SosoIlea/PetFeeder/PetFeederFinal.pdf

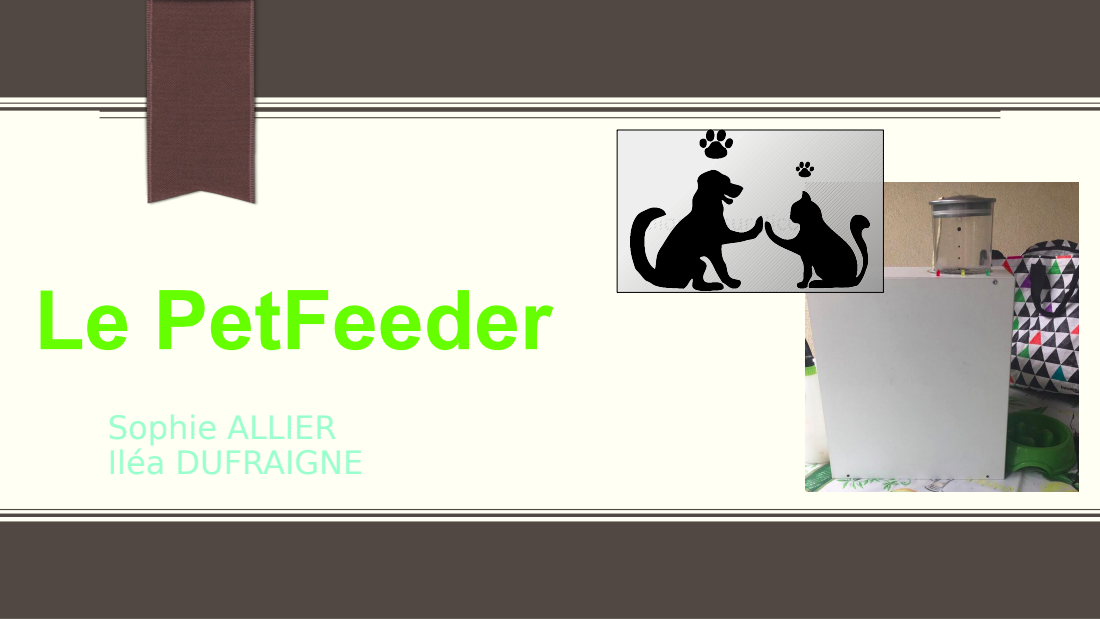
[picture p7: page 1]
Le PetFeeder; Sophie ALLIER Iléa DUFRAIGNE

Cliquez sur l'icône pour ajouter une image

# Sommaire

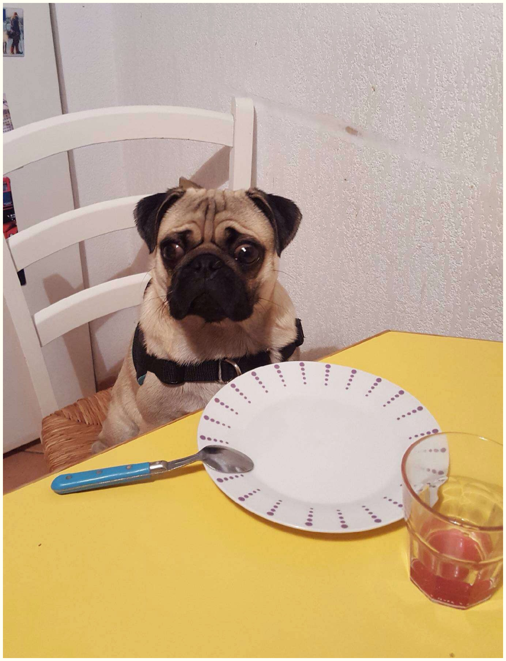
[picture p8: figure]

# - Description - Objectifs - Schémas et matériel - Problèmes rencontrés - Bonus - Perspectives

# Description

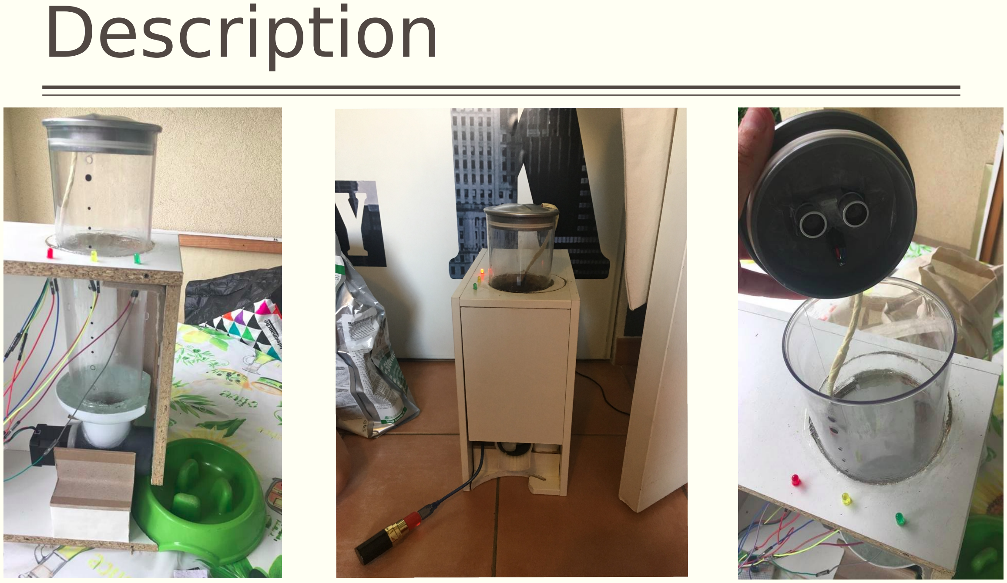
[picture p9: page 3]

# Objectifs

De départ | De fin

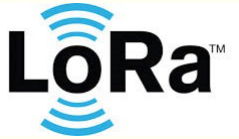
[picture p10: figure]

Utilisation d'une molette et d'un petit moteur pas-à-pas

Utilisation d'une hélice, d'un tuyau et d'un moteur plus puissant

# Tous nos autres objectifs n'ont pas changé !

# Diagramme de Gantt suivi

Tâches | Décembre | Janvier | Février | Mars | Avril | Mai | Juin

Réflexion

Préparation

Programmation

Vérifications

Montage

Finalisation | | | | | | | FIN !!!
Sophie | Iléa | Sophie & Iléa

# Schémas et matériel

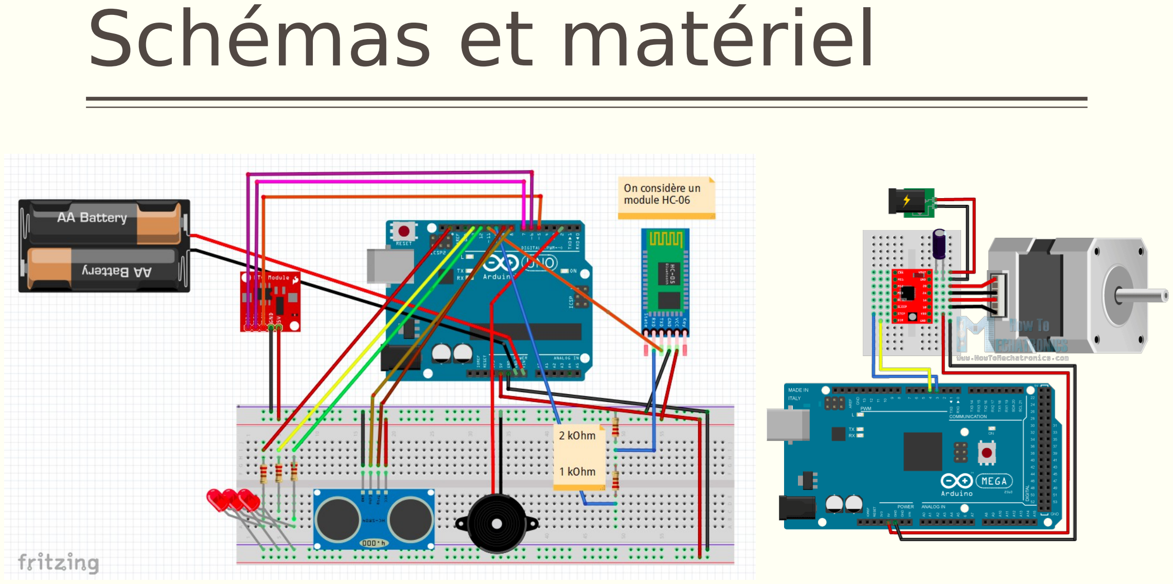
[picture p11: page 6]

# Problèmes rencontrés

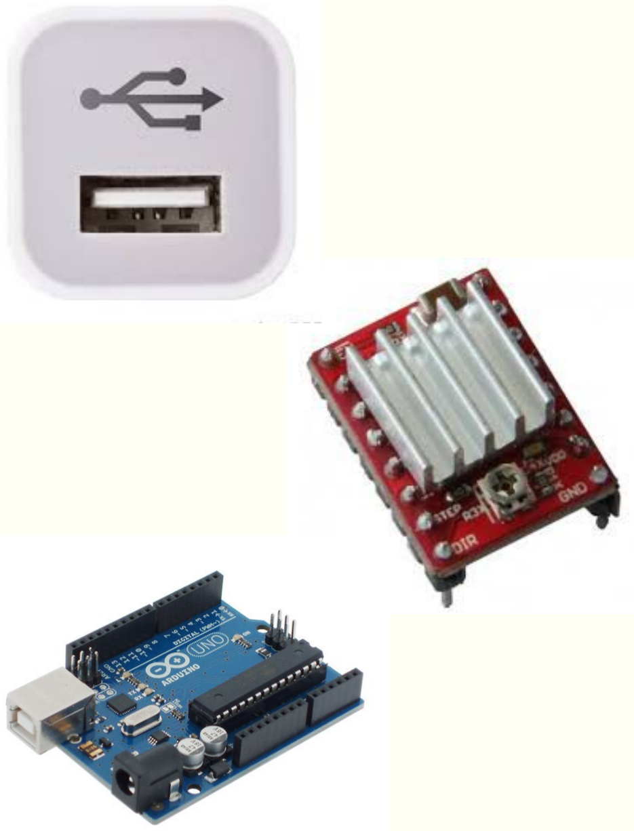
[picture p12: figure]

# ●Problèmes mécaniques

# ●Problèmes éléctroniques

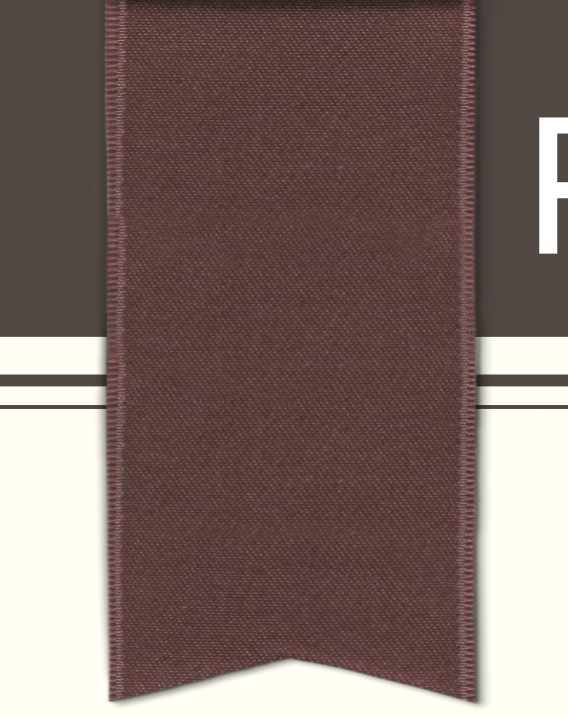
[picture p13: figure]

# Palmarès du binôme de choc :

# - 1 plaque - 1 PWM - 1 module Bluetooth - 1 port USB - 2 cartes Arduino - 4 drivers

## Le talent

Trop fortes

Pour le plus grand plaisir de M.Masson ...

# Perspectives

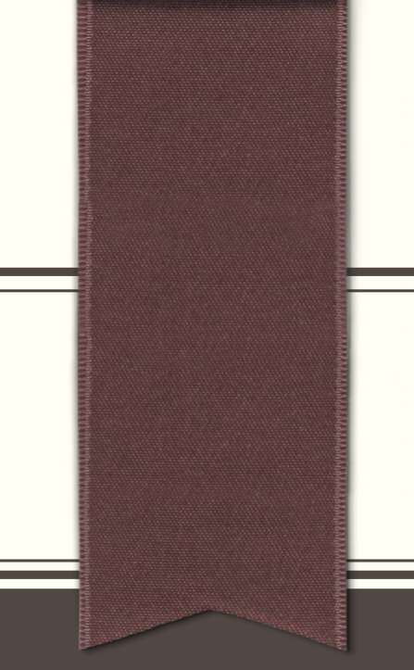
[picture p14: figure]

# - Travailler en équipe

# - Elaborer un projet sur une longue période

# - Faire face aux difficultés et les surmonter

# Merci de votre écoute !

Utilisation pour
d'autres
animaux

Pas de prise
12V

## Possibilité de créer une application pour utiliser le module LoRa
