SosoIlea/PetFeeder/repertoire/doc/Photos/33066060_2187783017917541_4268476646387875840_n.jpg

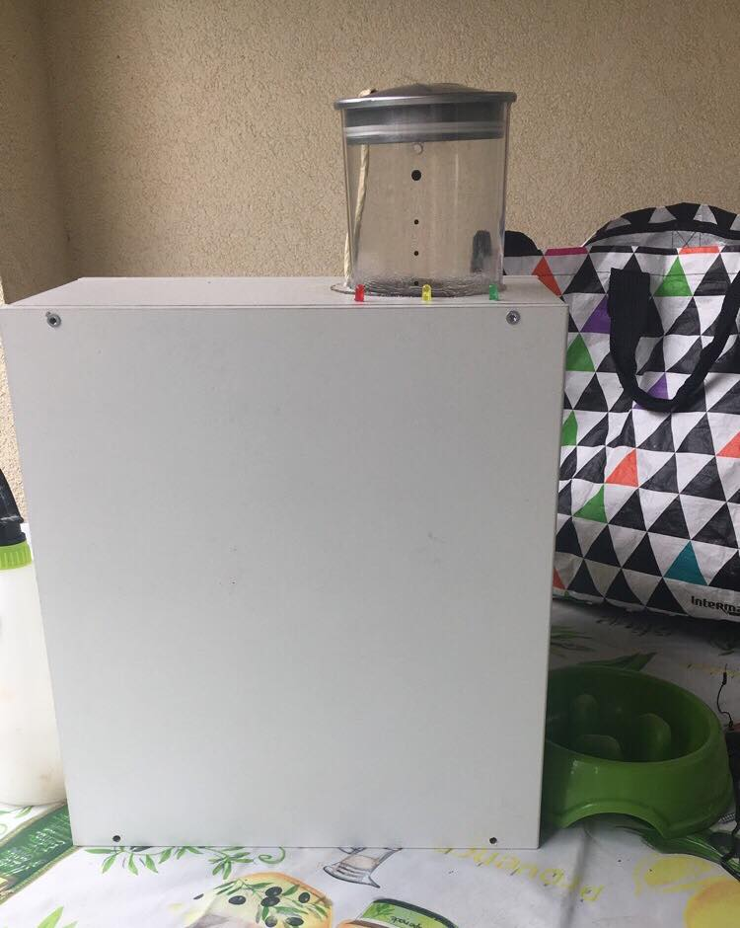
repertoire/doc/Photos/33066060_2187783017917541_4268476646387875840_n.jpg
