SosoIlea/PetFeeder/repertoire/doc/Photos/33100535_2187783351250841_3870072525073416192_n.jpg

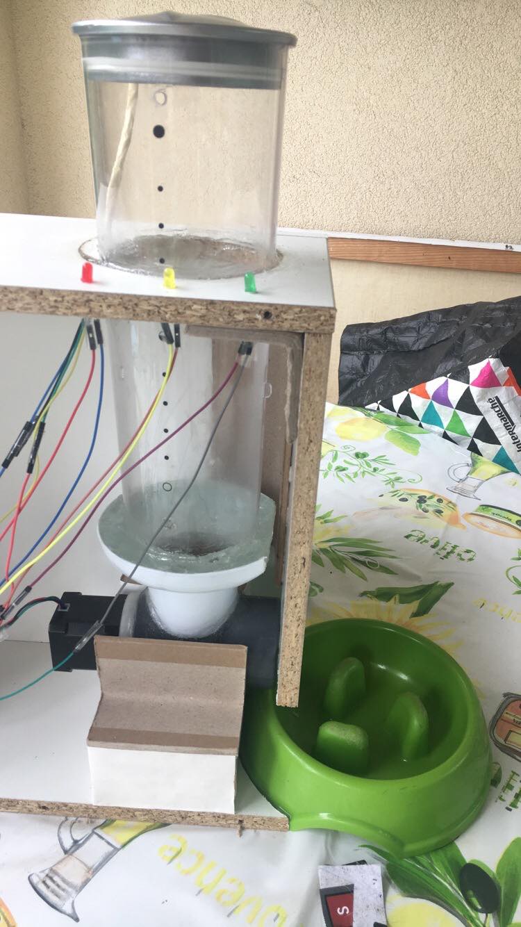
repertoire/doc/Photos/33100535_2187783351250841_3870072525073416192_n.jpg
