SosoIlea/PetFeeder/repertoire/doc/Photos/BD39CEA2-42DF-4465-9EC5-68898302F27A.jpeg

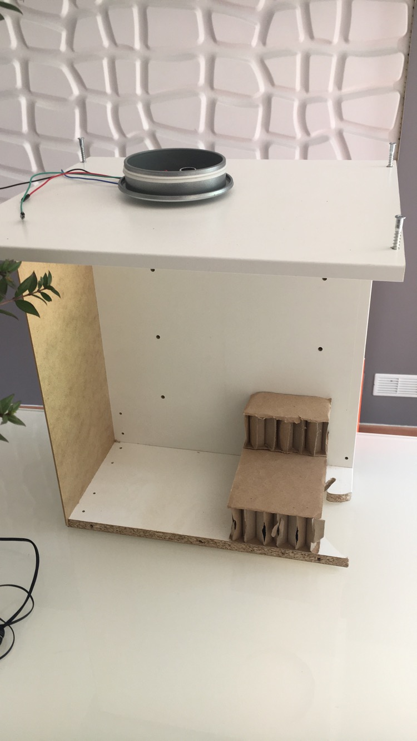
repertoire/doc/Photos/BD39CEA2-42DF-4465-9EC5-68898302F27A.jpeg
