SosoIlea/PetFeeder/repertoire/doc/Photos/BFC08A79-5608-4789-B0F6-804772E7318F.jpeg

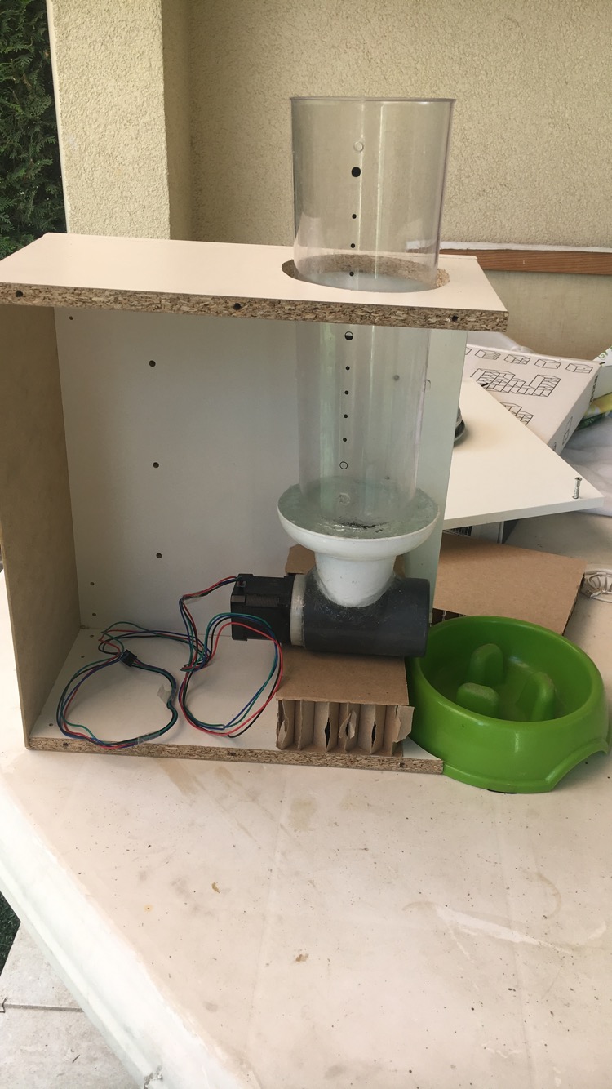
repertoire/doc/Photos/BFC08A79-5608-4789-B0F6-804772E7318F.jpeg
