SosoIlea/PetFeeder/repertoire/doc/Montage/Schema-montage-moteur.png

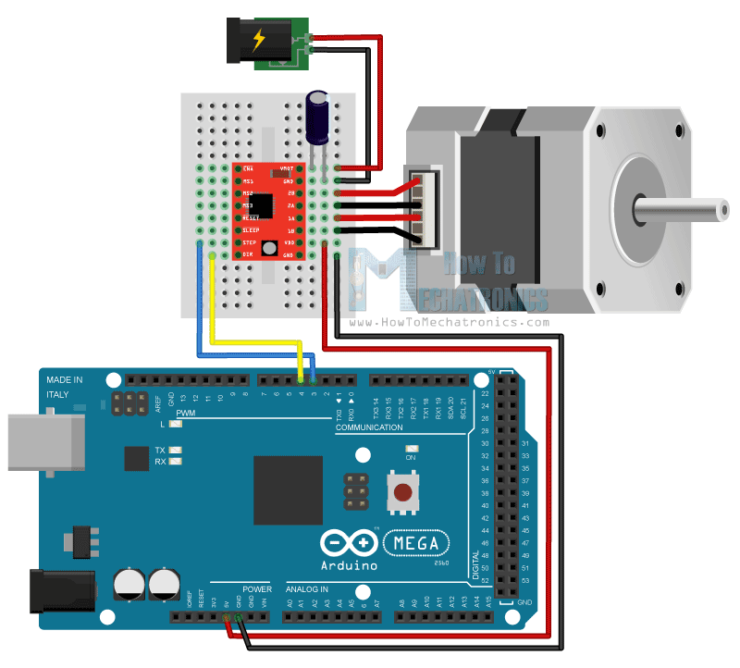
repertoire/doc/Montage/Schema-montage-moteur.png
