SosoIlea/PetFeeder/PetFeefer1.pdf

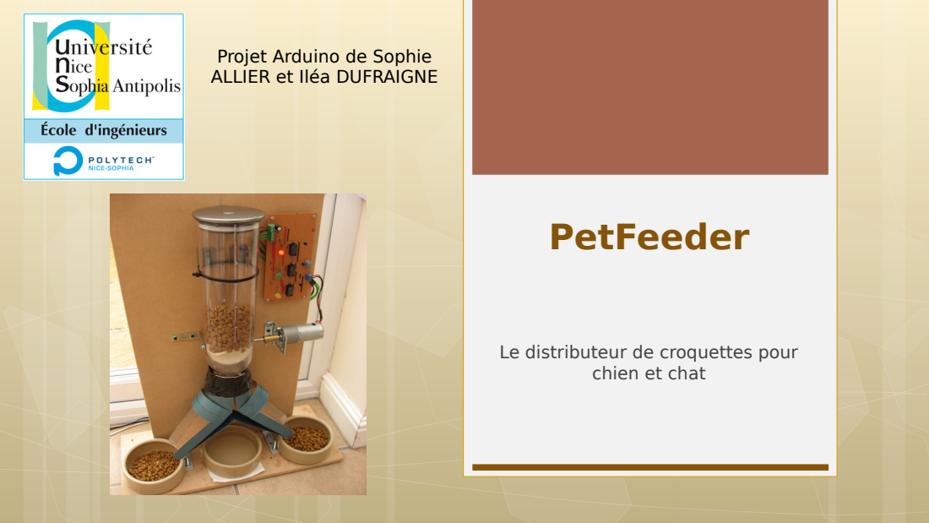
[picture p27: page 1]
PetFeeder

Projet Arduino de Sophie
ALLIER et Iléa DUFRAIGNE

Le distributeur de croquettes pour

chien et chat

## Sommaire

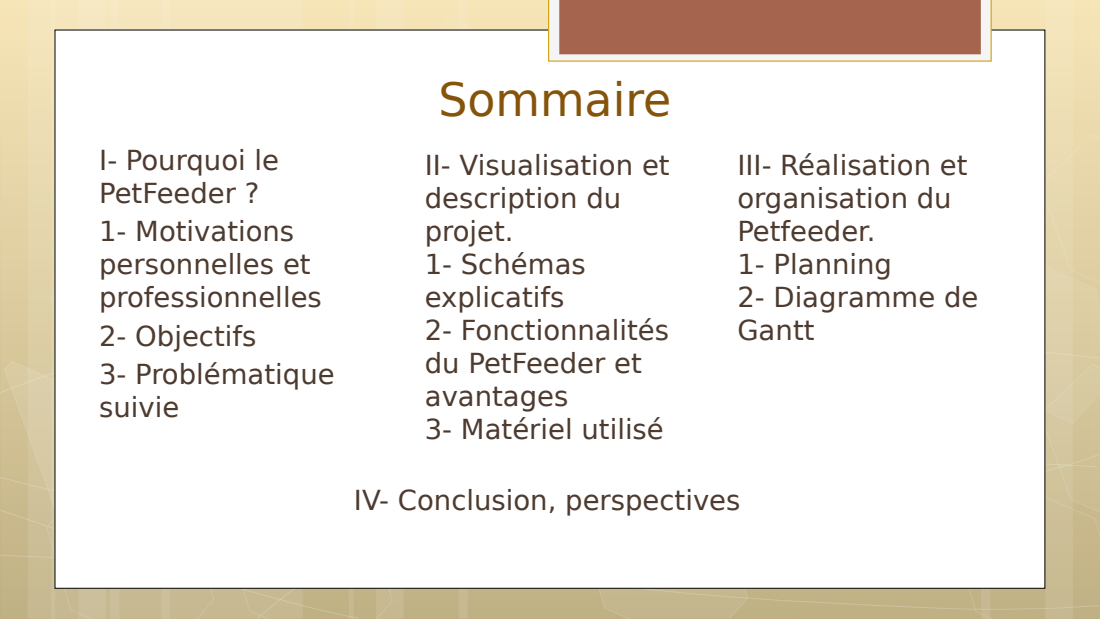
[picture p28: page 2]
I- Pourquoi le PetFeeder ? 1- Motivations personnelles et professionnelles 2- Objectifs 3- Problématique suivie

II- Visualisation et
description du
projet.
1- Schémas
explicatifs
2- Fonctionnalités
du PetFeeder et
avantages
3- Matériel utilisé

III- Réalisation et
organisation du
Petfeeder.
1- Planning
2- Diagramme de
Gantt

IV- Conclusion, perspectives

## Motivations

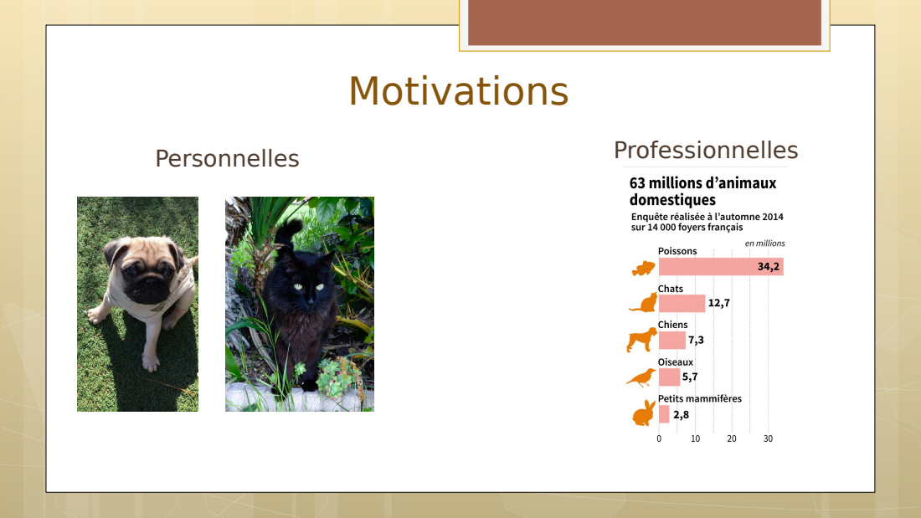
[picture p29: page 3]
Personnelles; Professionnelles

# Objectifs & Problématique

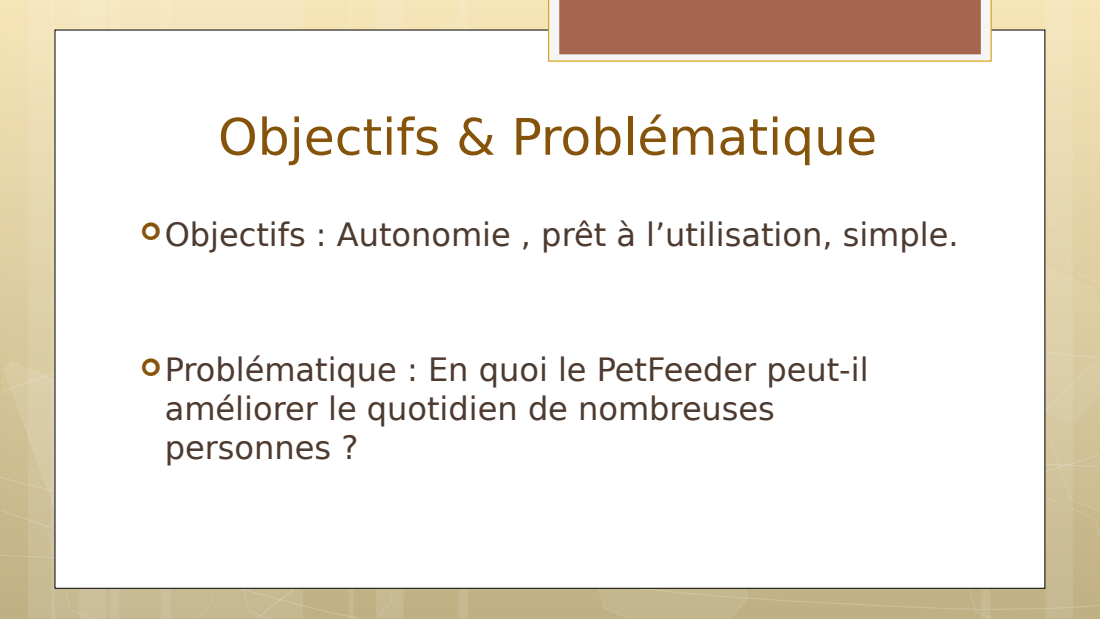
[picture p30: page 4]

Objectifs : Autonomie , prêt à l’utilisation, simple.

Problématique : En quoi le PetFeeder peut-il
améliorer le quotidien de nombreuses
personnes ?

# Schémas

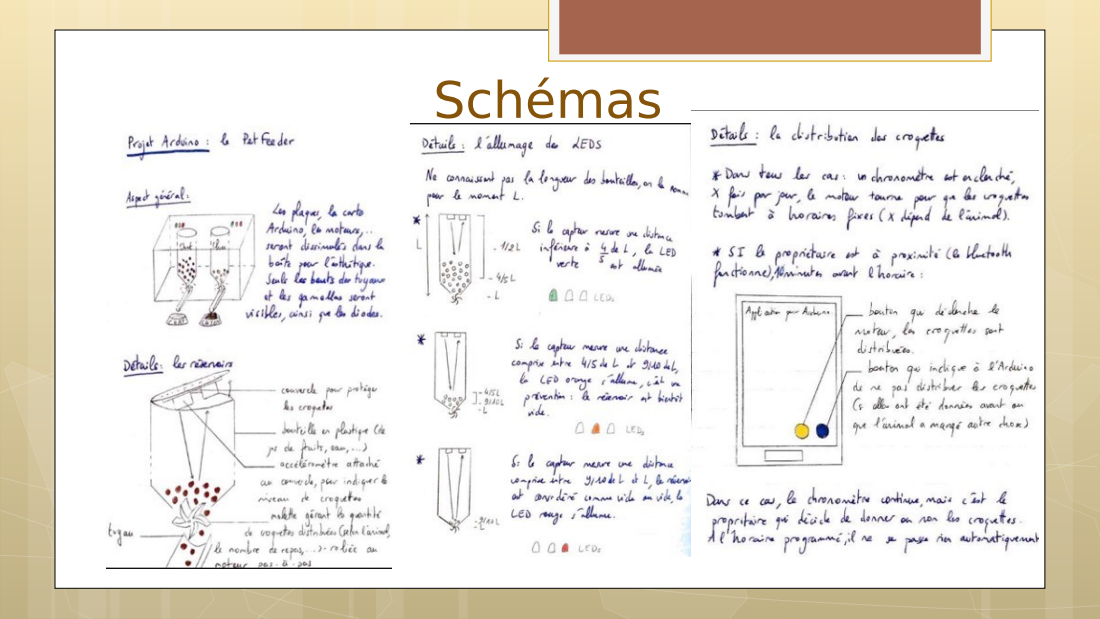
[picture p31: page 5]

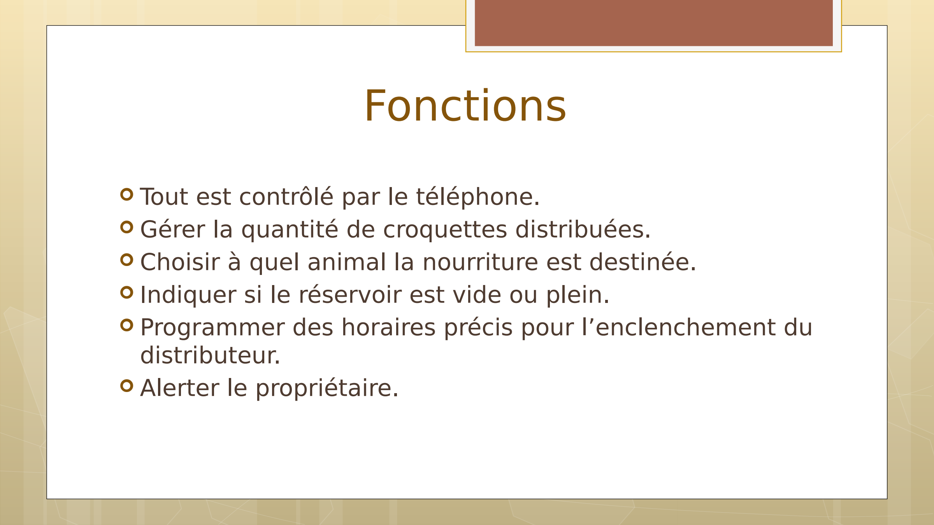
[picture p32: figure]
Fonctions; Tout est contrôlé par le téléphone.; distributeur. Alerter le propriétaire.

Gérer la quantité de croquettes distribuées.
Choisir à quel animal la nourriture est destinée.
Indiquer si le réservoir est vide ou plein.
Programmer des horaires précis pour l’enclenchement du

# Matériel utilisé

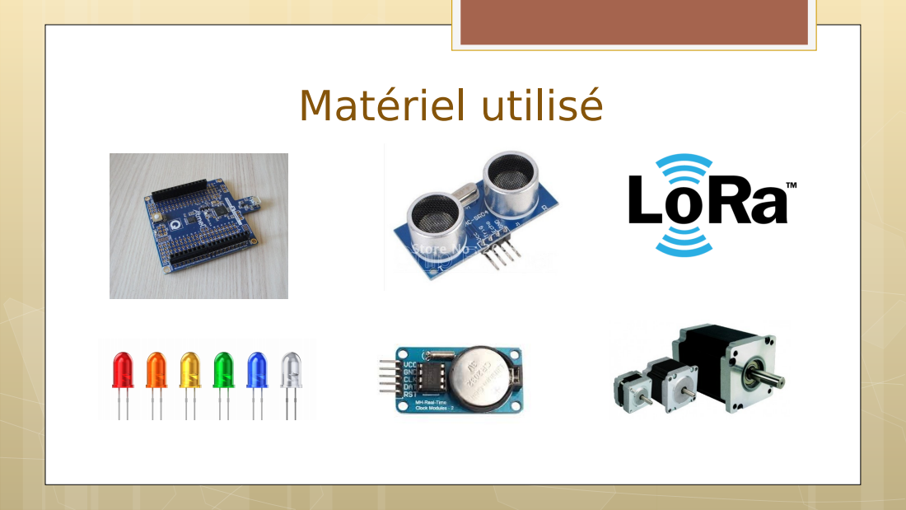
[picture p33: page 7]

# Planning

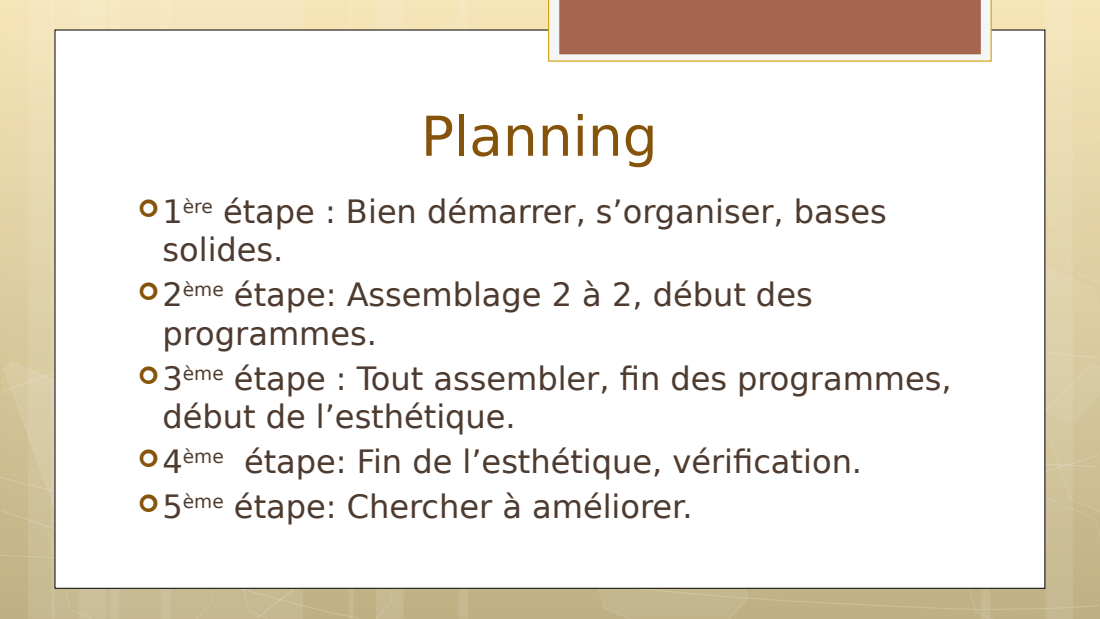
[picture p34: page 8]

1ère étape : Bien démarrer, s’organiser, bases
solides.
2ème étape: Assemblage 2 à 2, début des
programmes.
3ème étape : Tout assembler, fin des programmes,
début de l’esthétique.
4ème étape: Fin de l’esthétique, vérification.
5ème étape: Chercher à améliorer.

# Diagramme de Gantt

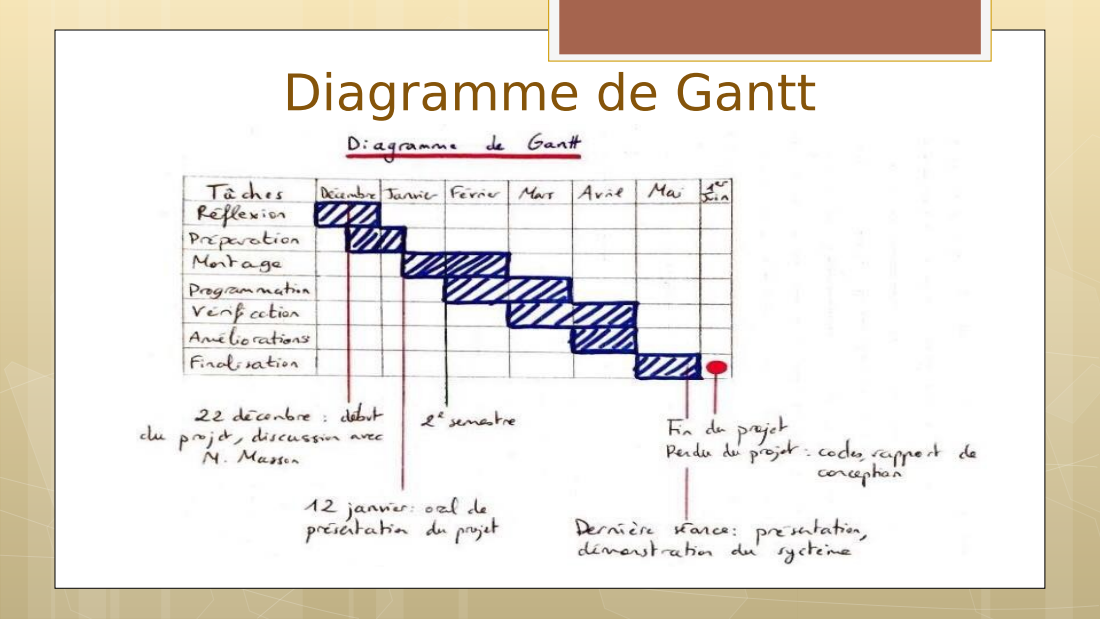
[picture p35: page 9]

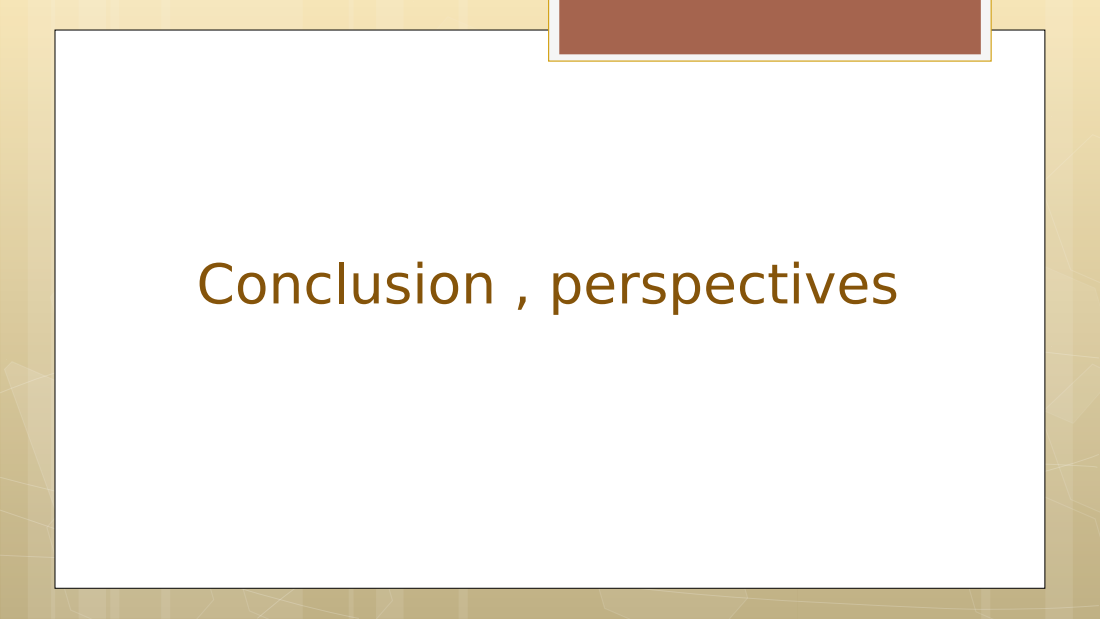
[picture p36: page 10]
Conclusion , perspectives
